Catsarepro21/hackpad_v2/README.md

# Macropad
A custom macropad with 6 keys, bluetooth(ESP32-S3), battery, RGB, 2 and rotary encoders. This is my second macropad, because the first one wasn't that good but I still have parts some parts left over from it. 

Files:

[PCB](PCB)

[Case](https://github.com/Catsarepro21/hackpad_v2/blob/main/case)

[Gerbers](PCB/gerbers.zip)

BOM: [BOM.md](BOM.md)

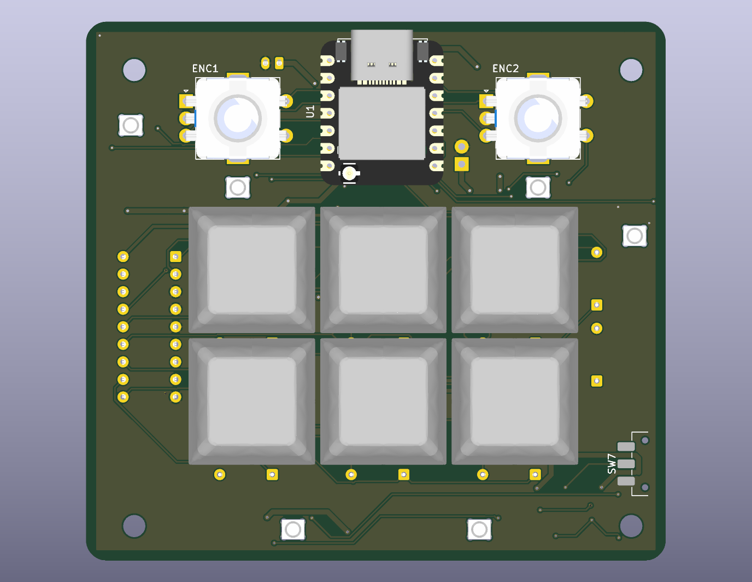
[picture p1: images/PCB-top.png]
PCB top


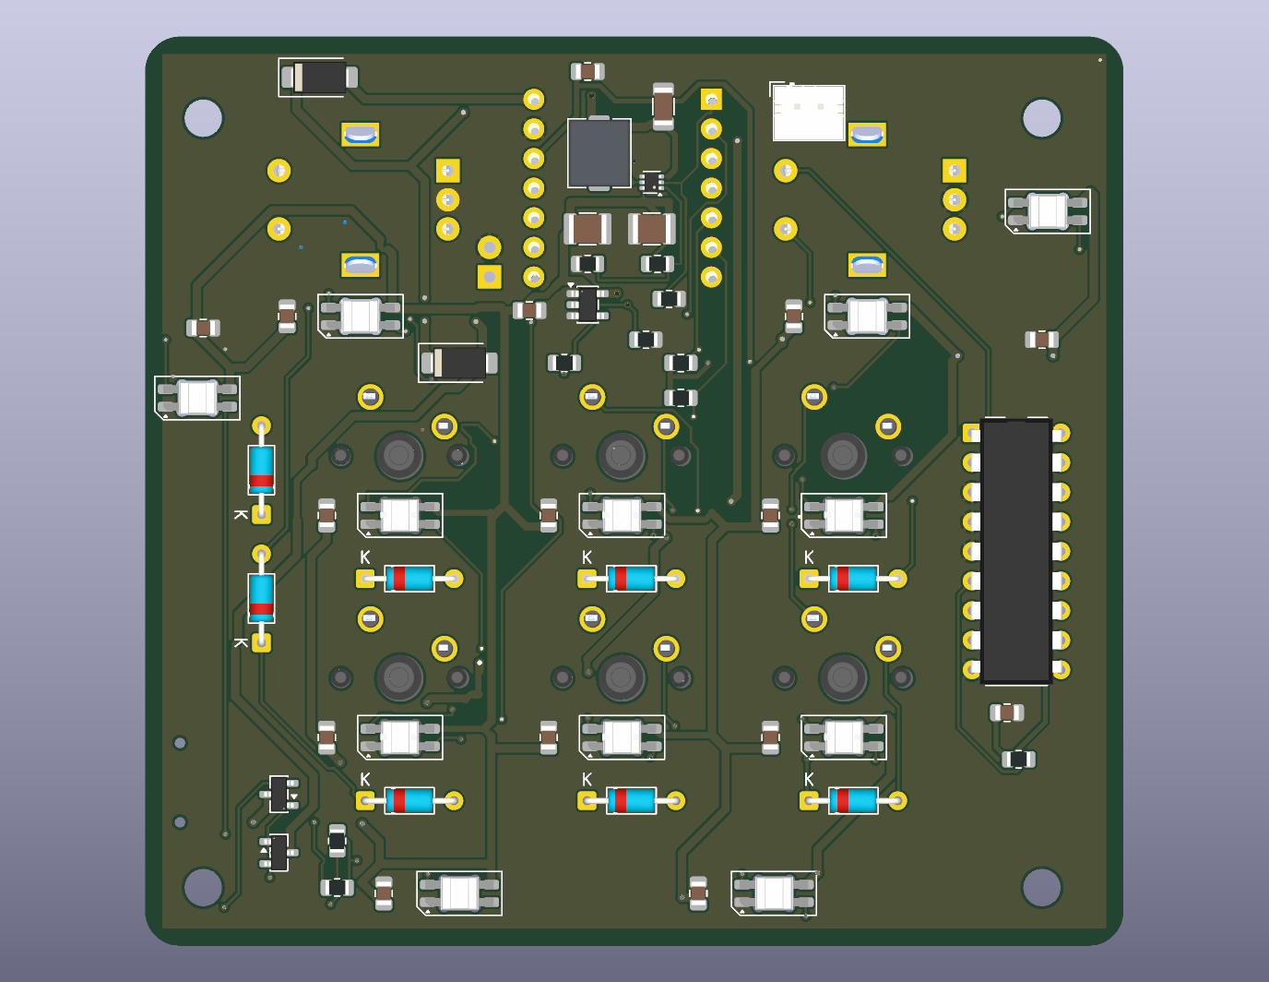
[picture p2: images/PCB-bottom.png]
PCB bottom


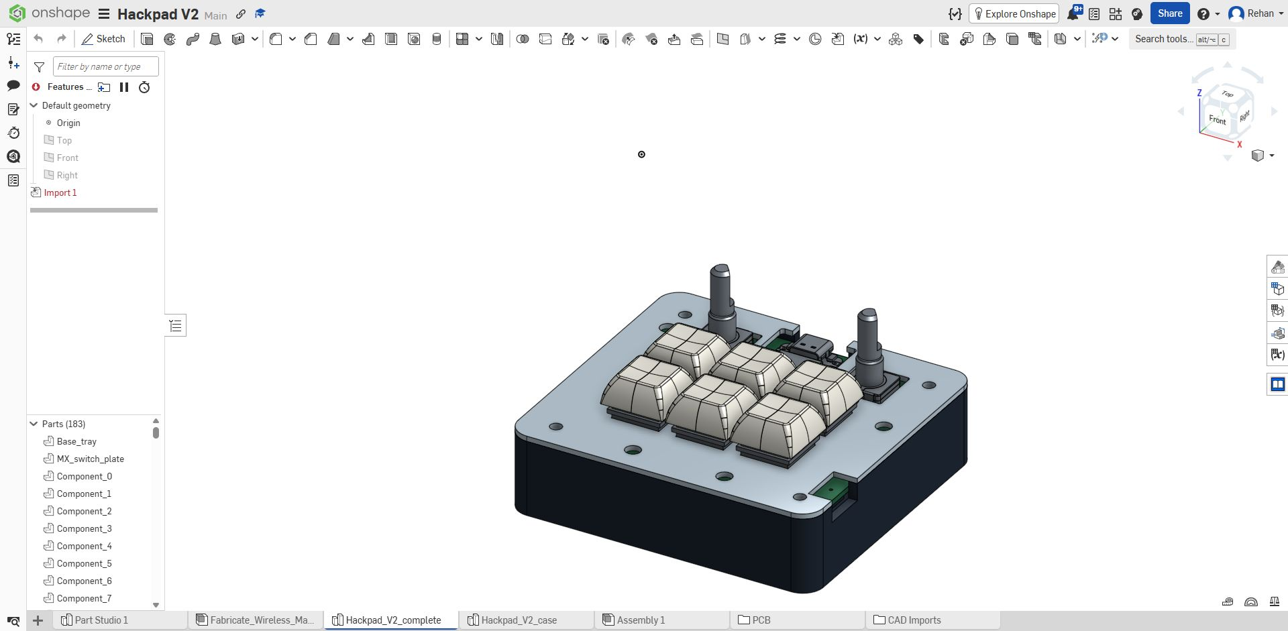
[picture p3: images/Onshape-enclosure.jpg]
Case


[Onshape](https://cad.onshape.com/documents/e5e00bd96b00b1f98fd3bff8/w/d80bdedc56342f5387c6fe9a/e/f05423852afba8350f5d5474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)
