Catsarepro21/hackpad_v2/BOM.md

| Reference/use | Part | Needed | Cart quantity | Line USD |
|---|---|---:|---:|---:|
| U1 | XIAO ESP32-S3 113991114, 1597-113991114-ND | 1 | 1 | 7.49 |
| J1 | B2B-PH-K-S, 455-1704-ND | 1 | 1 | 0.12 |
| U1 sockets | PPTC071LFBN-RC, S7005-ND | 2 | 2 | 1.16 |
| U1 male headers | Seeed 102010490 five-pack | 2 strips | 1 pack | 0.25 |
| U4 | SN74AHCT1G125DBVR, 296-4708-1-ND | 1 | 1 | 0.14 |
| R8,R9 | RC0805FR-07100KL, 311-100KCRCT-ND | 2 | 10 | 0.36 |
| R7 | RC0805FR-07330RL, 311-330CRCT-ND | 1 | 1 | 0.10 |
| R10 | RC0805FR-071KL, 311-1.00KCRCT-ND | 1 | 1 | 0.10 |
| Battery pad leads | Adafruit 1954 wire pack, 1528-1964-ND | 1 pair | 1 pack | 1.95 |
| Q1,Q2 | AO3401A, 785-1001-1-ND | 2 | 2 | 1.04 |
| C1,C6-C18 | CC0805KRX7R9BB104 100nF 50V X7R 0805, 311-1140-1-ND | 14 | 14 | 1.37 |
| C4 | CL32B226KOJNNNE 22uF 16V X7R 1210, 1276-1855-1-ND | 1 | 1 | 0.64 |
| SW7 | JS102011SAQN, 401-1999-1-ND | 1 | 1 | 0.90 |
| Battery | Adafruit 1578 protected 500mAh, 1528-1841-ND | 1 | 1 | 7.95 |
| PCB fabrication | JLCPCB | 1 board | 5 boards | 2.00 |
| Case printing | Printing Legion? Or friend | 1 case | 1 case | ? |
| Subtotal |  |  |  | 25.57 |
| Shipping |  |  |  | 16.44 |
| Total |  |  |  | 42.01 |
