Catsarepro21/hackpad_v2/case/Base_tray.step

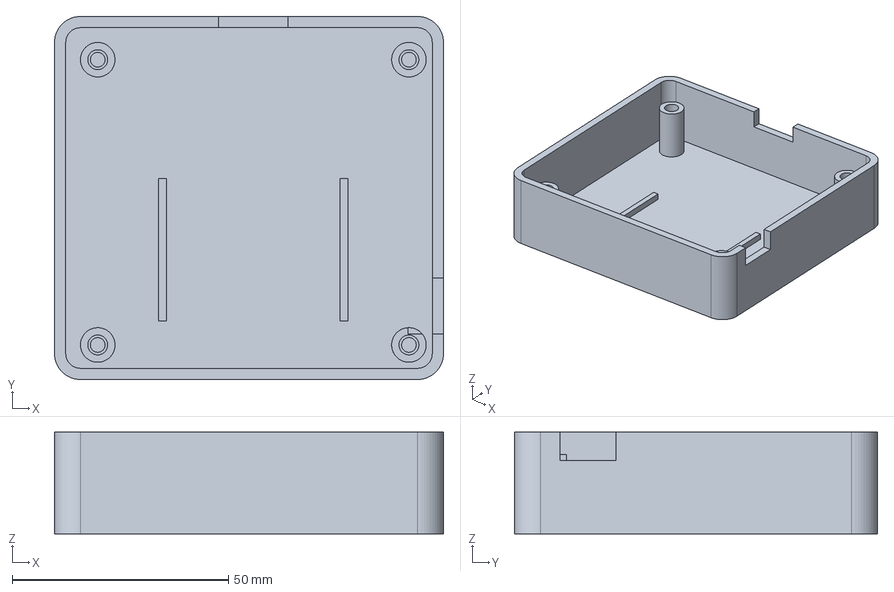
[picture p4: CAD file, 2026-10-19]
case/Base_tray.step
90.0 x 84.0 x 23.5 mm
