Catsarepro21/hackpad_v2/(list of files, cad)

Other CAD files:
case/Base_tray.stl
