Catsarepro21/hackpad_v2/JOURNAL.md

---
title: "Hackpad"
github: "https://github.com/Catsarepro21/hackpad_v2"
description: "A(nother) custom hackpad! I made one before for Keeb but it was really bad because I wasn't that good at PCB's, so i'm making a much better one, and I even have some parts left over."
created_at: "2026-10-15"
total_time: "6h 42m"
---

# October 15, 2026: Schematic, PCB, code, and case, so pretty much everything
<!-- fabricate:entry 503 -->

So I first wanted a much better layout, so I started by drawing in excalidraw.


. 
Then I started on the schematic, and I wanted bluetooth on this hackpad rather than not, and chose to add RGB under every key and around the edges. Then I made the schematic using an ESP32-S3(Kinda overkill but good for making it simpler), added all the RGB, rotary encoders, i removed the OLED cuz i lost it, and made sure to have a switch and battery connecter, and added 3d models for the parts from grabcad, just for reference to make sure it looked good and assigned all the footprints based on the known parts that I already have.



Then i made the PCB, and I just used normal 19.05 mx spacing and layed it out pretty quickly. I just dragged out the footprints in the grid for the keys and encoder, and I did the same for the ESP32, other parts i layed out where there was space to keep it square and I added RGB right under every key. And of course, i added M3 mounting holes so it would actually stay in my case.



After that i made the case in onshape, I imported the PCB and just added a margin, made a sketch based on the PCB and mounting holes, and extruded to make the bottom half. Then I used ai03 Plate Generator to generate the top half DXF and extended it and extruded the mounting holes through it, and added a hole for the switch.


Finally I made really basic code pretty quickly using Arduino IDE, and i did use Gemini's help a bit on this part but i did write it myself.

**Total time spent: 4h 30m**

# October 17, 2026: Cheapified
<!-- fabricate:entry 619 -->

I simplified the hackpad to bring the estimated parts order down to **$34.07 before tax**:

- Connected the keys and encoder clicks directly to the XIAO, so I don’t need to populate the MCP23008 or its supporting parts.
- Made RGB USB-only, letting me leave the battery RGB boost converter and its supporting parts unpopulated.
- Kept those extra footprints on the PCB so I can add the features later.
- Switched to a smaller protected 500mAh battery and used the XIAO’s built-in charger.
- Reused my existing switches, keycaps, encoders, LEDs, diodes, screws, and inserts.
- Consolidated the new parts into one DigiKey order.



**Total time spent: 1h 30m**

# October 20, 2026: Simplified Schematic and updated README and expanded Journal
<!-- fabricate:entry 772 -->

So today all i did was simplify the schematic by copying and pasting everything onto one page and removing the net labels and replacing with wires. Then I rewrote my readme and expanded my previous journals.



**Total time spent: 42m**
