Catsarepro21/hackpad_v2/PCB/Fabricate_Wireless_Macropad.kicad_pcb

## KiCad design PCB/Fabricate_Wireless_Macropad.kicad_pcb (2026-10-20)

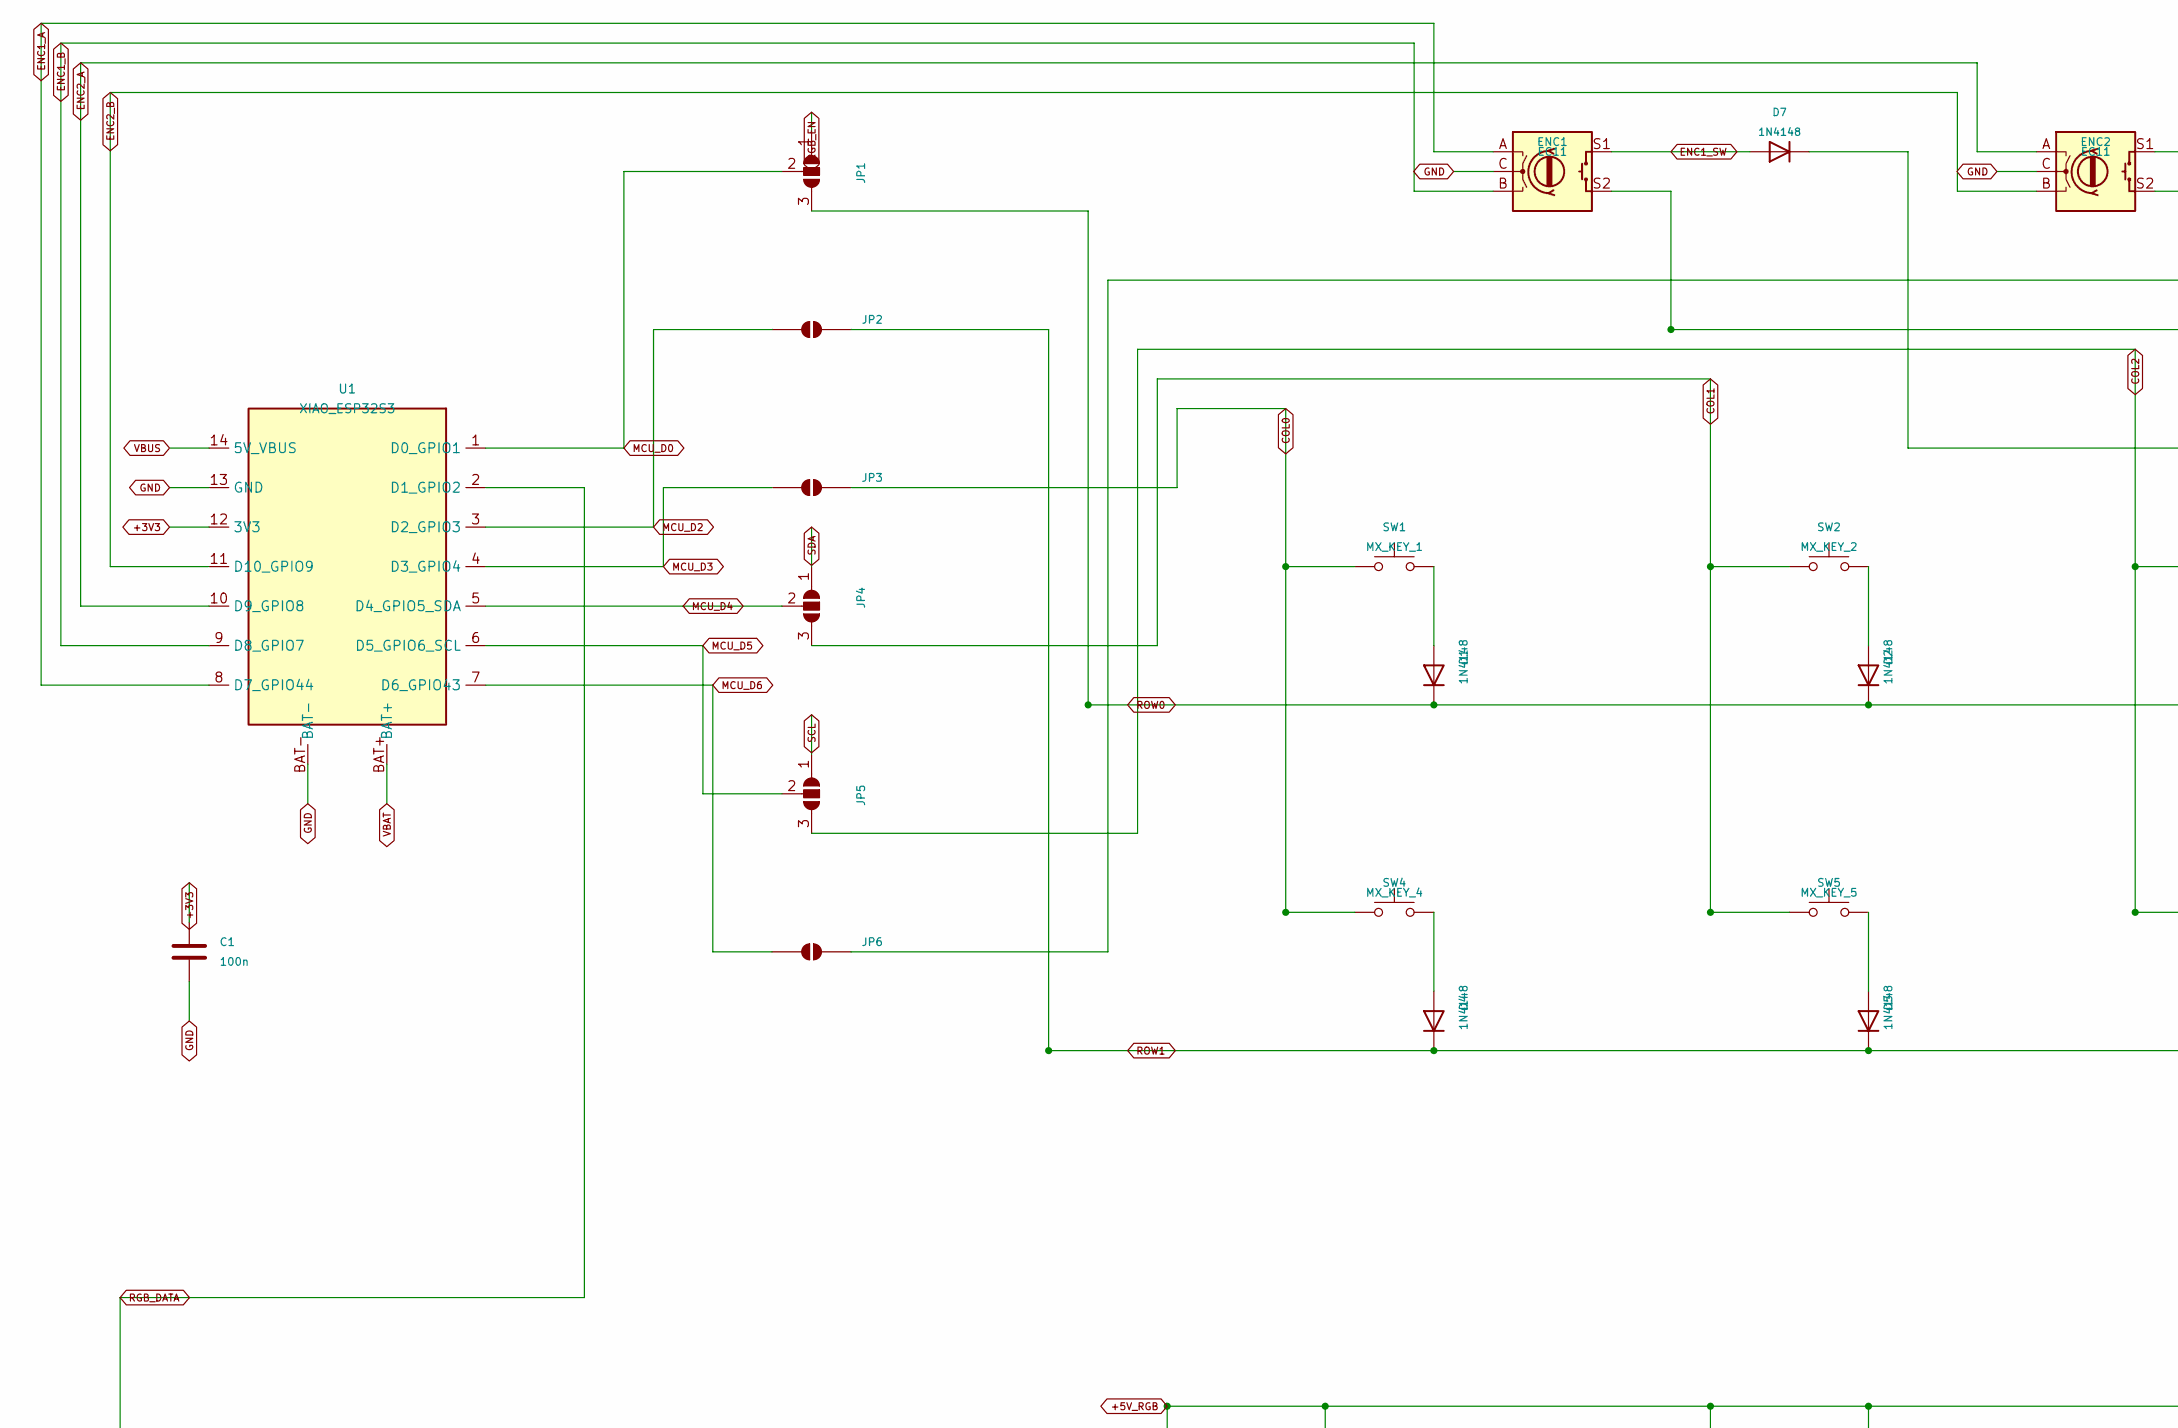
[picture p5: schematic Fabricate_Wireless_Macropad.kicad_sch, Hackpad V2 - complete circuit, part in row 1, column 1]

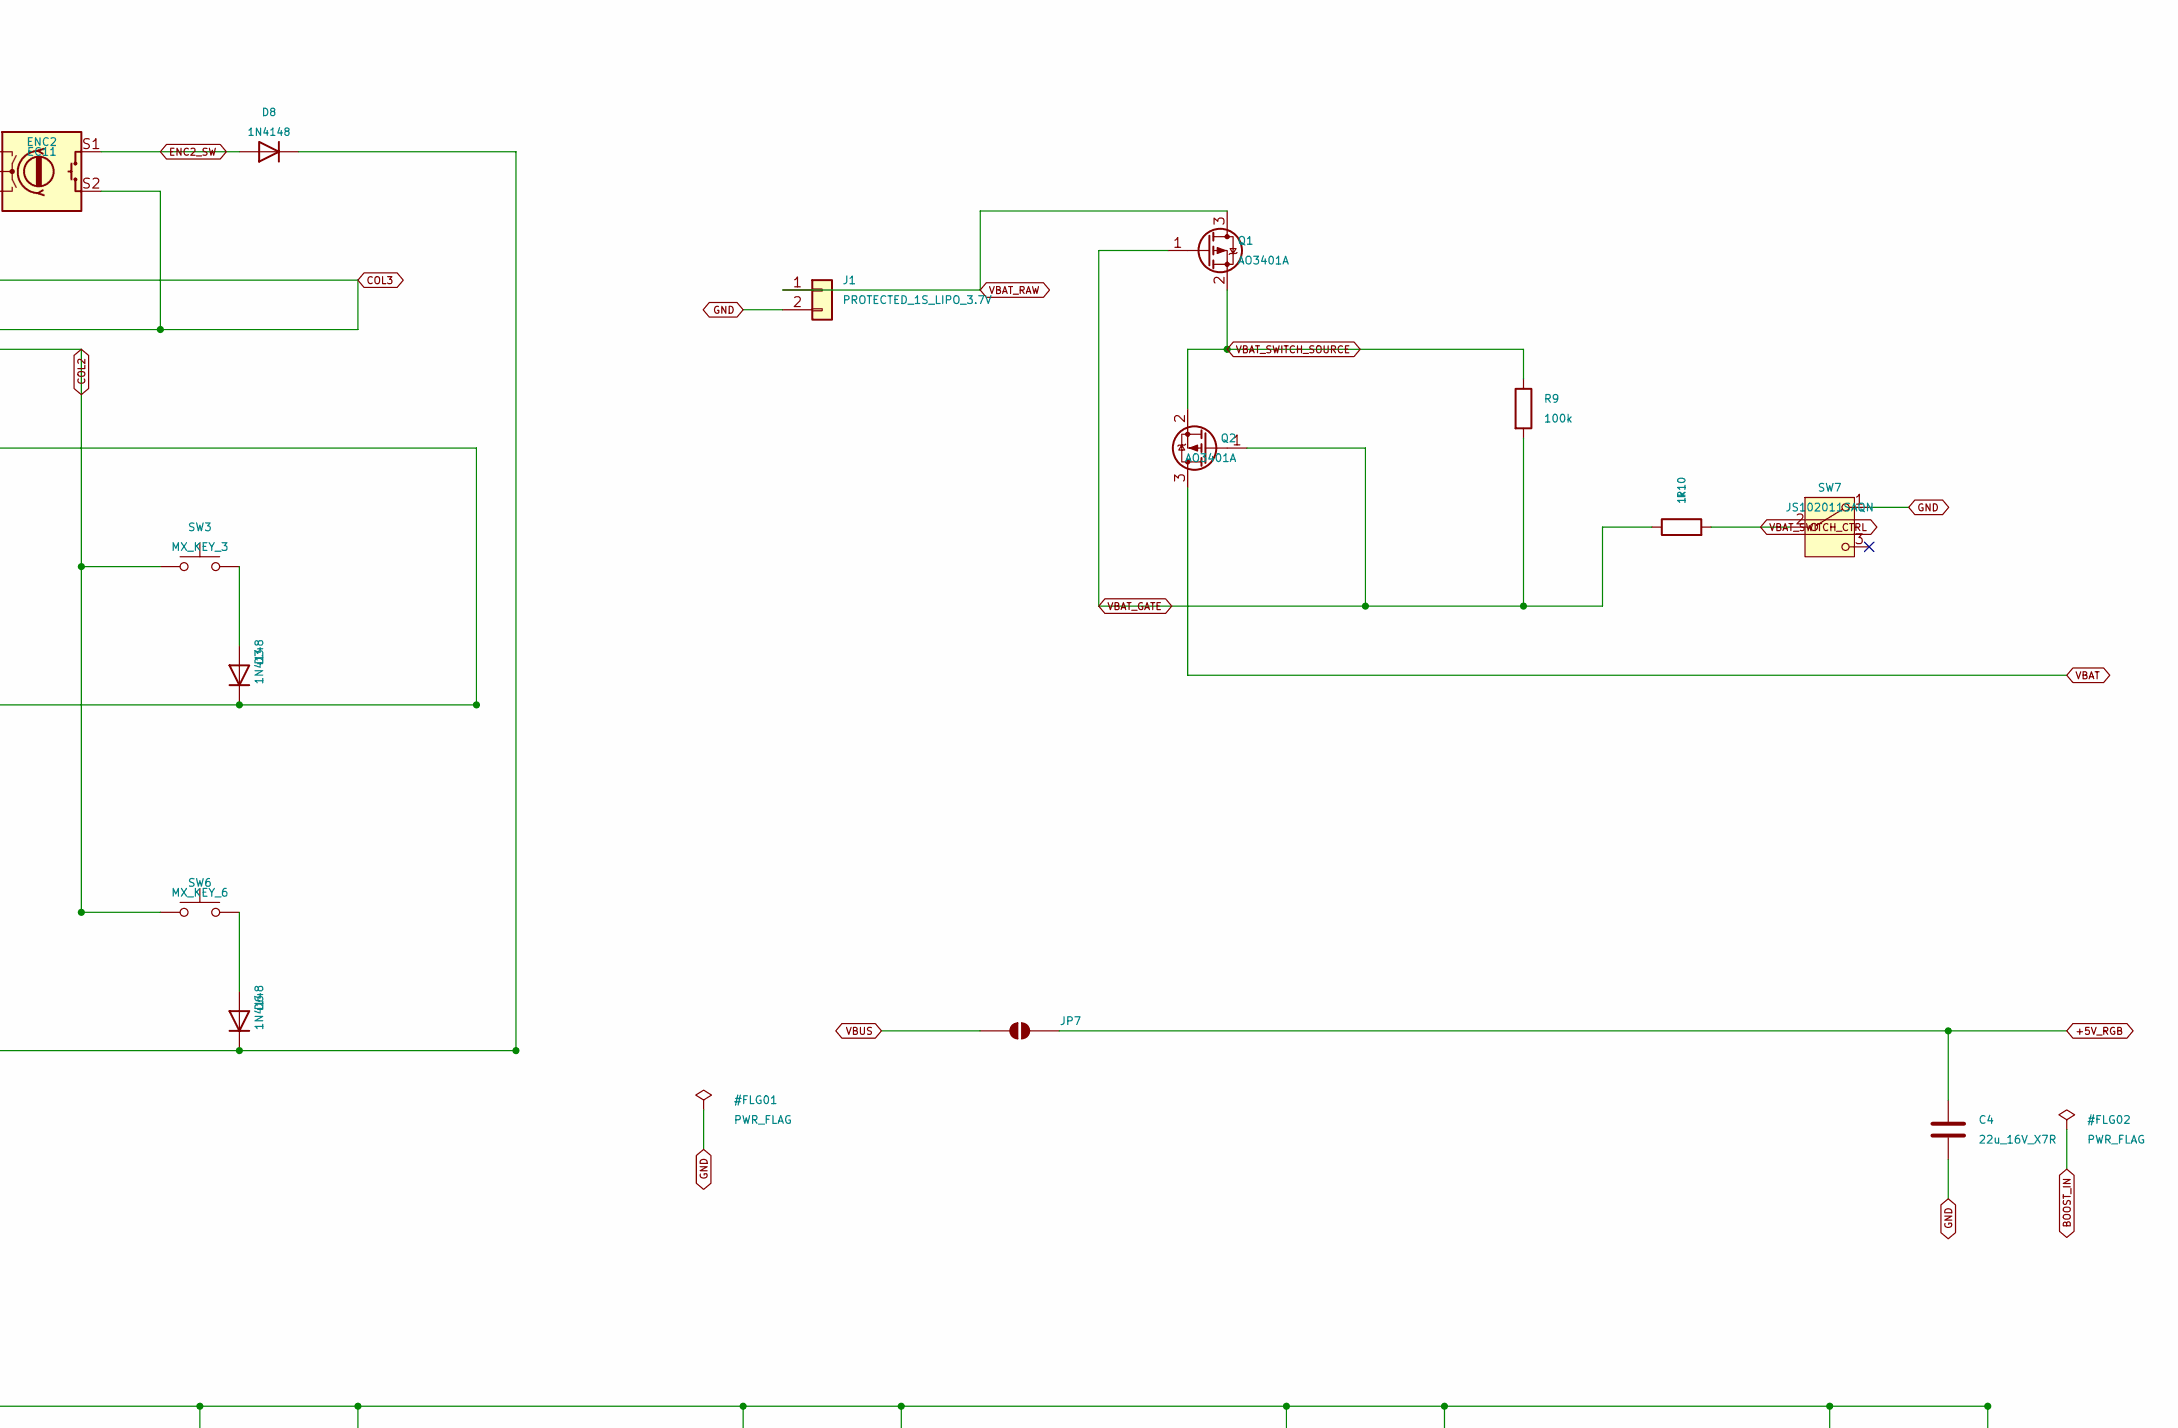
[picture p6: schematic Fabricate_Wireless_Macropad.kicad_sch, Hackpad V2 - complete circuit, part in row 1, column 2]

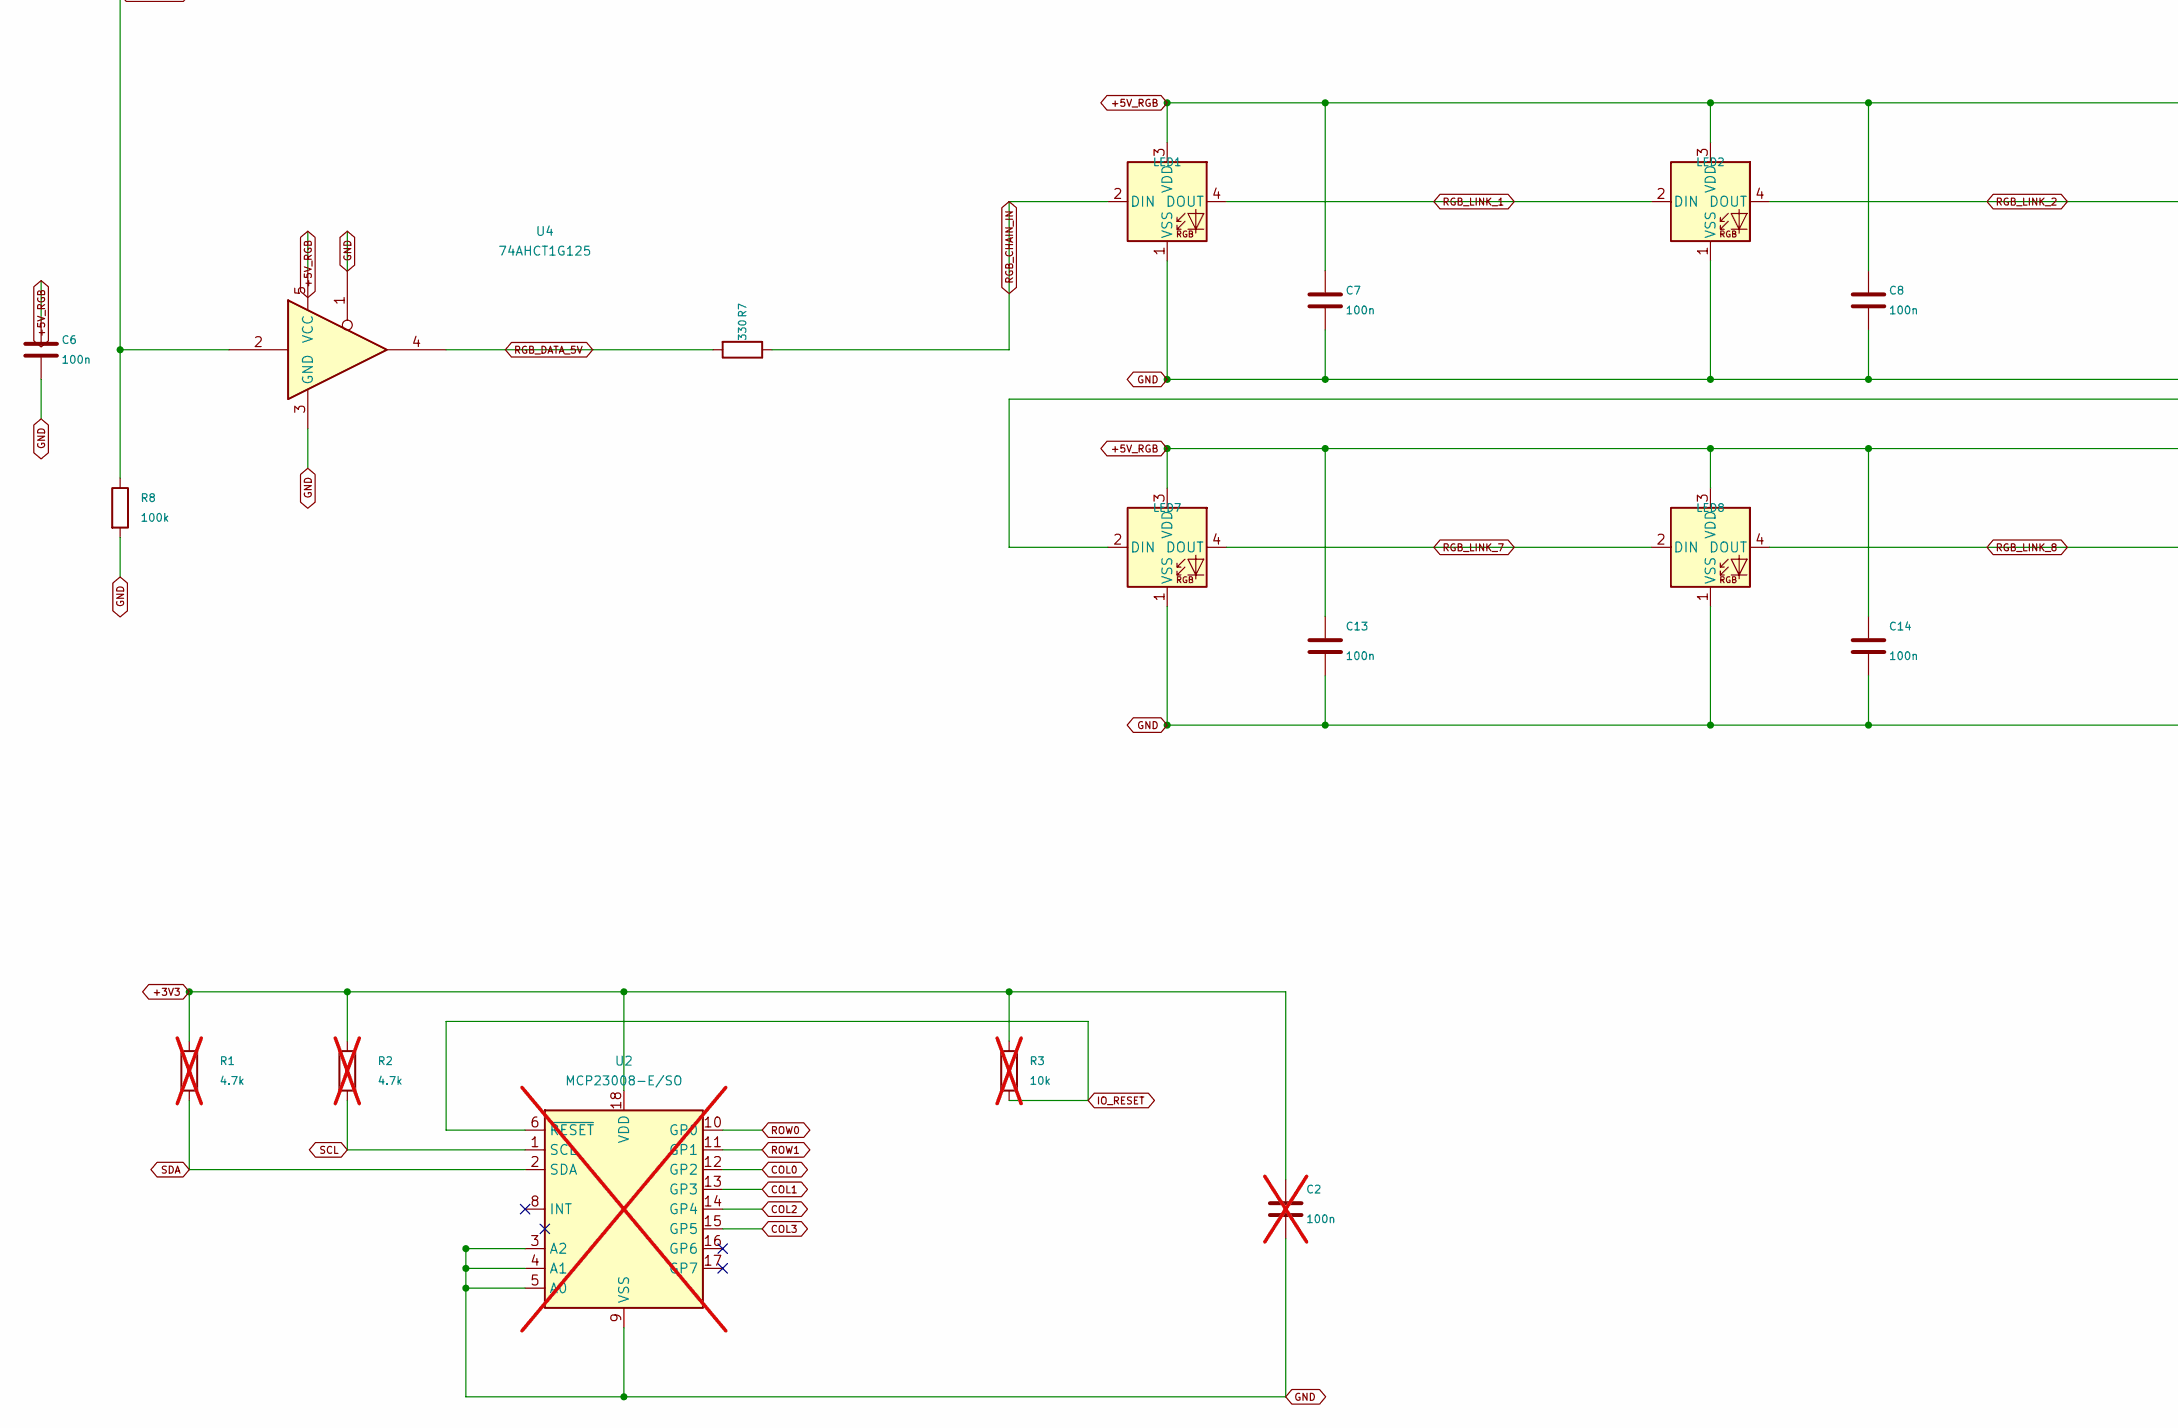
[picture p7: schematic Fabricate_Wireless_Macropad.kicad_sch, Hackpad V2 - complete circuit, part in row 2, column 1]

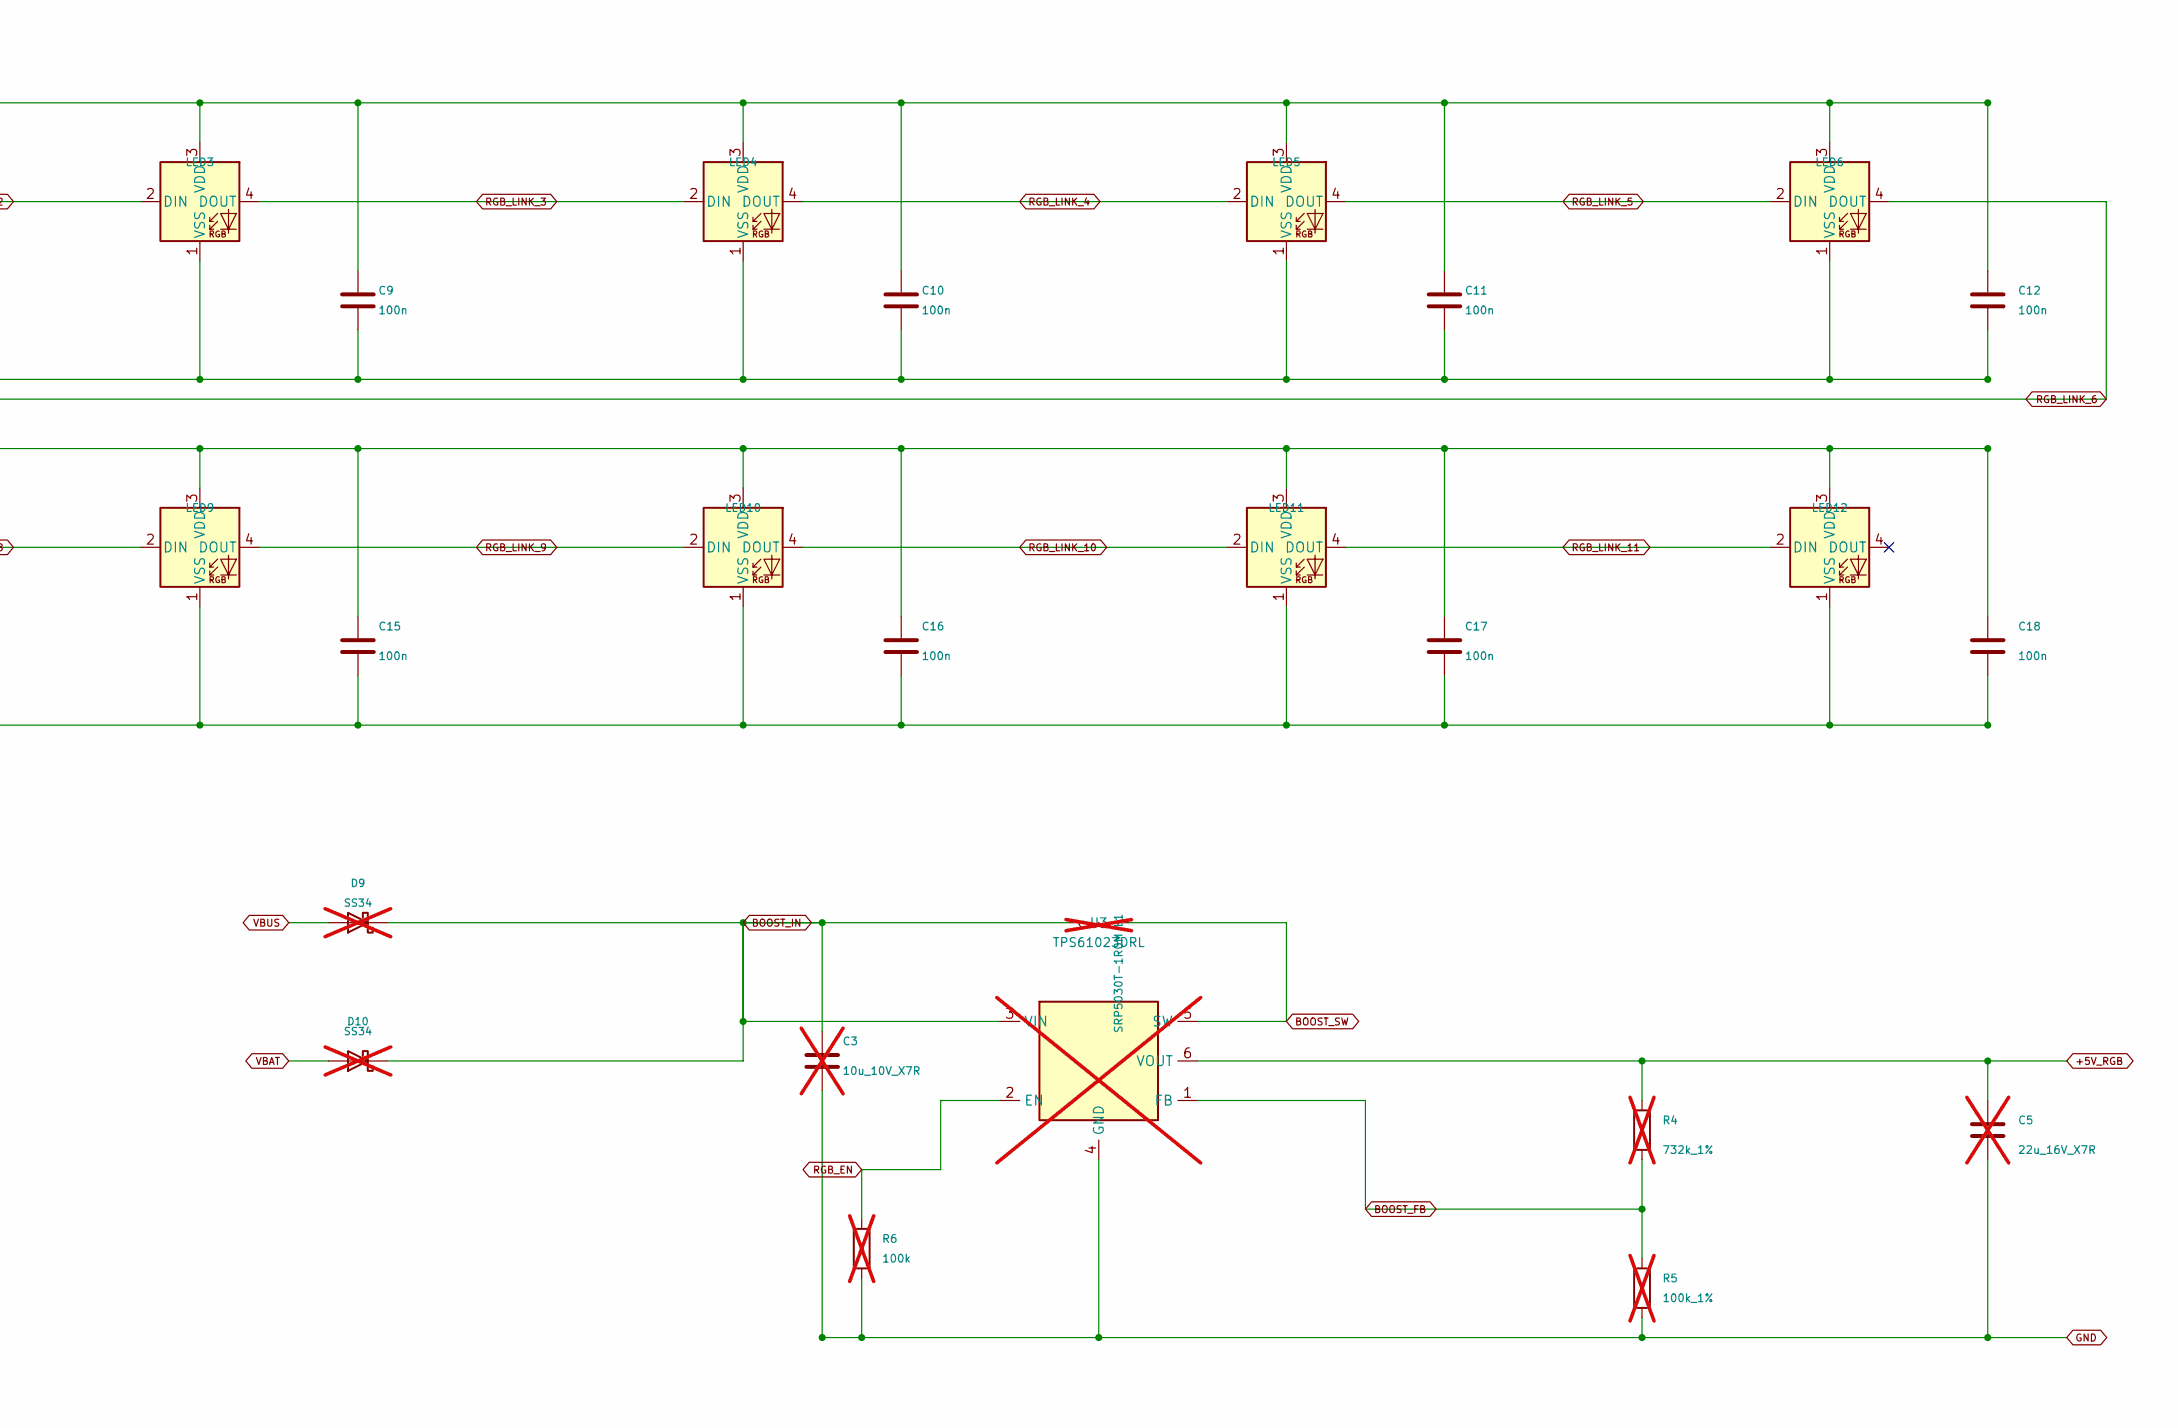
[picture p8: schematic Fabricate_Wireless_Macropad.kicad_sch, Hackpad V2 - complete circuit, part in row 2, column 2]

Parts:
C1, C6, C7, C8, C9, C10, C11, C12, C13, C14, C15, C16, C17, C18: 100n; C_0805_2012Metric
C2: 100n; C_0805_2012Metric; not fitted
C3: 10u_10V_X7R; C_1206_3216Metric; MPN C1206C106K8RACTU; LCSC C2167669; not fitted
C4: 22u_16V_X7R; C_1210_3225Metric; MPN CL32B226KOJNFNE; LCSC C16196563
C5: 22u_16V_X7R; C_1210_3225Metric; MPN CL32B226KOJNFNE; LCSC C16196563; not fitted
D1, D2, D3, D4, D5, D6, D7, D8: 1N4148; D_DO-35_SOD27_P7.62mm_Horizontal
D9, D10: SS34; D_SMA; not fitted
ENC1, ENC2: EC11; RotaryEncoder_Alps_EC11E-Switch_Vertical_H20mm
J1: PROTECTED_1S_LIPO_3.7V; JST_PH_B2B-PH-K_1x02_P2.00mm_Vertical
JP1, JP4, JP5: MODE_SELECT; SolderJumper-3_P1.3mm_Open_Pad1.0x1.5mm
JP2, JP3, JP6, JP7: MODE_SELECT; SolderJumper-2_P1.3mm_Open_Pad1.0x1.5mm
L1: SRP5030T-1R0M; L_Bourns_SRP5030T; MPN SRP5030T-1R0M; not fitted
LED1: KEY_1; LED_SK6812MINI-E_3.2x2.8mm_P1.5mm_ReverseMount; MPN SK6812MINI-E
LED2: KEY_2; LED_SK6812MINI-E_3.2x2.8mm_P1.5mm_ReverseMount; MPN SK6812MINI-E
LED3: KEY_3; LED_SK6812MINI-E_3.2x2.8mm_P1.5mm_ReverseMount; MPN SK6812MINI-E
LED4: KEY_4; LED_SK6812MINI-E_3.2x2.8mm_P1.5mm_ReverseMount; MPN SK6812MINI-E
LED5: KEY_5; LED_SK6812MINI-E_3.2x2.8mm_P1.5mm_ReverseMount; MPN SK6812MINI-E
LED6: KEY_6; LED_SK6812MINI-E_3.2x2.8mm_P1.5mm_ReverseMount; MPN SK6812MINI-E
LED7: ENC_1; LED_SK6812MINI-E_3.2x2.8mm_P1.5mm_ReverseMount; MPN SK6812MINI-E
LED8: ENC_2; LED_SK6812MINI-E_3.2x2.8mm_P1.5mm_ReverseMount; MPN SK6812MINI-E
LED9: EDGE_1; LED_SK6812MINI-E_3.2x2.8mm_P1.5mm_ReverseMount; MPN SK6812MINI-E
LED10: EDGE_2; LED_SK6812MINI-E_3.2x2.8mm_P1.5mm_ReverseMount; MPN SK6812MINI-E
LED11: EDGE_3; LED_SK6812MINI-E_3.2x2.8mm_P1.5mm_ReverseMount; MPN SK6812MINI-E
LED12: EDGE_4; LED_SK6812MINI-E_3.2x2.8mm_P1.5mm_ReverseMount; MPN SK6812MINI-E
Q1, Q2: AO3401A; SOT-23
R1, R2: 4.7k; R_0805_2012Metric; not fitted
R3: 10k; R_0805_2012Metric; not fitted
R4: 732k_1%; R_0805_2012Metric; not fitted
R5: 100k_1%; R_0805_2012Metric; not fitted
R6: 100k; R_0805_2012Metric; not fitted
R7: 330; R_0805_2012Metric
R8, R9: 100k; R_0805_2012Metric
R10: 1k; R_0805_2012Metric
SW1: MX_KEY_1; SW_Cherry_MX_1.00u_PCB
SW2: MX_KEY_2; SW_Cherry_MX_1.00u_PCB
SW3: MX_KEY_3; SW_Cherry_MX_1.00u_PCB
SW4: MX_KEY_4; SW_Cherry_MX_1.00u_PCB
SW5: MX_KEY_5; SW_Cherry_MX_1.00u_PCB
SW6: MX_KEY_6; SW_Cherry_MX_1.00u_PCB
SW7: JS102011SAQN; SW_SPDT_CK_JS102011SAQN
U1: XIAO_ESP32S3; XIAO_S3_Socket_WiredBattery
U2: MCP23008-E/SO; SOIC-18W_7.5x11.6mm_P1.27mm; MPN MCP23008-E/SO; not fitted
U3: TPS61023DRL; SOT-563; not fitted
U4: 74AHCT1G125; SOT-23-5

Connections:
+3V3: C1.1, C2.1, R1.1, R2.1, R3.1, U1.12 (3V3), U2.18 (VDD)
+5V_RGB: C4.1, C5.1, C6.1, C7.1, C8.1, C9.1, C10.1, C11.1, C12.1, C13.1, C14.1, C15.1, C16.1, C17.1, C18.1, JP7.2 (B), LED1.3 (VDD), LED2.3 (VDD), LED3.3 (VDD), LED4.3 (VDD), LED5.3 (VDD), LED6.3 (VDD), LED7.3 (VDD), LED8.3 (VDD), LED9.3 (VDD), LED10.3 (VDD), LED11.3 (VDD), LED12.3 (VDD), R4.1, U3.6 (VOUT), U4.5 (VCC)
BOOST_FB: R4.2, R5.1, U3.1 (FB)
BOOST_IN: C3.1, D9.1 (K), D10.1 (K), L1.2, U3.3 (VIN)
BOOST_SW: L1.1, U3.5 (SW)
COL0: JP3.2 (B), SW1.1, SW4.1, U2.12 (GP2)
COL1: JP4.3 (B), SW2.1, SW5.1, U2.13 (GP3)
COL2: JP5.3 (B), SW3.1, SW6.1, U2.14 (GP4)
COL3: ENC1.S2, ENC2.S2, JP6.2 (B), U2.15 (GP5)
ENC1_A: ENC1.A, U1.8 (D7_GPIO44)
ENC1_B: ENC1.B, U1.9 (D8_GPIO7)
ENC1_SW: D7.2 (A), ENC1.S1
ENC2_A: ENC2.A, U1.10 (D9_GPIO8)
ENC2_B: ENC2.B, U1.11 (D10_GPIO9)
ENC2_SW: D8.2 (A), ENC2.S1
GND: C1.2, C2.2, C3.2, C4.2, C5.2, C6.2, C7.2, C8.2, C9.2, C10.2, C11.2, C12.2, C13.2, C14.2, C15.2, C16.2, C17.2, C18.2, ENC1.C, ENC2.C, J1.2, LED1.1 (VSS), LED2.1 (VSS), LED3.1 (VSS), LED4.1 (VSS), LED5.1 (VSS), LED6.1 (VSS), LED7.1 (VSS), LED8.1 (VSS), LED9.1 (VSS), LED10.1 (VSS), LED11.1 (VSS), LED12.1 (VSS), R5.2, R6.2, R8.2, SW7.1 (A), U1.13 (GND), U1.BAT-, U2.3 (A2), U2.4 (A1), U2.5 (A0), U2.9 (VSS), U3.4 (GND), U4.1, U4.3 (GND)
IO_RESET: R3.2, U2.6 (~RESET)
MCU_D0: JP1.2 (C), U1.1 (D0_GPIO1)
MCU_D2: JP2.1 (A), U1.3 (D2_GPIO3)
MCU_D3: JP3.1 (A), U1.4 (D3_GPIO4)
MCU_D4: JP4.2 (C), U1.5 (D4_GPIO5_SDA)
MCU_D5: JP5.2 (C), U1.6 (D5_GPIO6_SCL)
MCU_D6: JP6.1 (A), U1.7 (D6_GPIO43)
unnamed: D1.2 (A), SW1.2
unnamed: D2.2 (A), SW2.2
unnamed: D3.2 (A), SW3.2
unnamed: D4.2 (A), SW4.2
unnamed: D5.2 (A), SW5.2
unnamed: D6.2 (A), SW6.2
RGB_CHAIN_IN: LED1.2 (DIN), R7.1
RGB_DATA: R8.1, U1.2 (D1_GPIO2), U4.2
RGB_DATA_5V: R7.2, U4.4
RGB_EN: JP1.1 (A), R6.1, U3.2 (EN)
RGB_LINK_1: LED1.4 (DOUT), LED2.2 (DIN)
RGB_LINK_2: LED2.4 (DOUT), LED3.2 (DIN)
RGB_LINK_3: LED3.4 (DOUT), LED4.2 (DIN)
RGB_LINK_4: LED4.4 (DOUT), LED5.2 (DIN)
RGB_LINK_5: LED5.4 (DOUT), LED6.2 (DIN)
RGB_LINK_6: LED6.4 (DOUT), LED7.2 (DIN)
RGB_LINK_7: LED7.4 (DOUT), LED8.2 (DIN)
RGB_LINK_8: LED8.4 (DOUT), LED9.2 (DIN)
RGB_LINK_9: LED9.4 (DOUT), LED10.2 (DIN)
RGB_LINK_10: LED10.4 (DOUT), LED11.2 (DIN)
RGB_LINK_11: LED11.4 (DOUT), LED12.2 (DIN)
ROW0: D1.1 (K), D2.1 (K), D3.1 (K), D7.1 (K), JP1.3 (B), U2.10 (GP0)
ROW1: D4.1 (K), D5.1 (K), D6.1 (K), D8.1 (K), JP2.2 (B), U2.11 (GP1)
SCL: JP5.1 (A), R2.2, U2.1 (SCL)
SDA: JP4.1 (A), R1.2, U2.2 (SDA)
VBAT: D10.2 (A), Q2.3 (D), U1.BAT+
VBAT_GATE: Q1.1 (G), Q2.1 (G), R9.2, R10.1
VBAT_RAW: J1.1, Q1.3 (D)
VBAT_SWITCH_CTRL: R10.2, SW7.2 (B)
VBAT_SWITCH_SOURCE: Q1.2 (S), Q2.2 (S), R9.1
VBUS: D9.2 (A), JP7.1 (A), U1.14 (5V_VBUS)

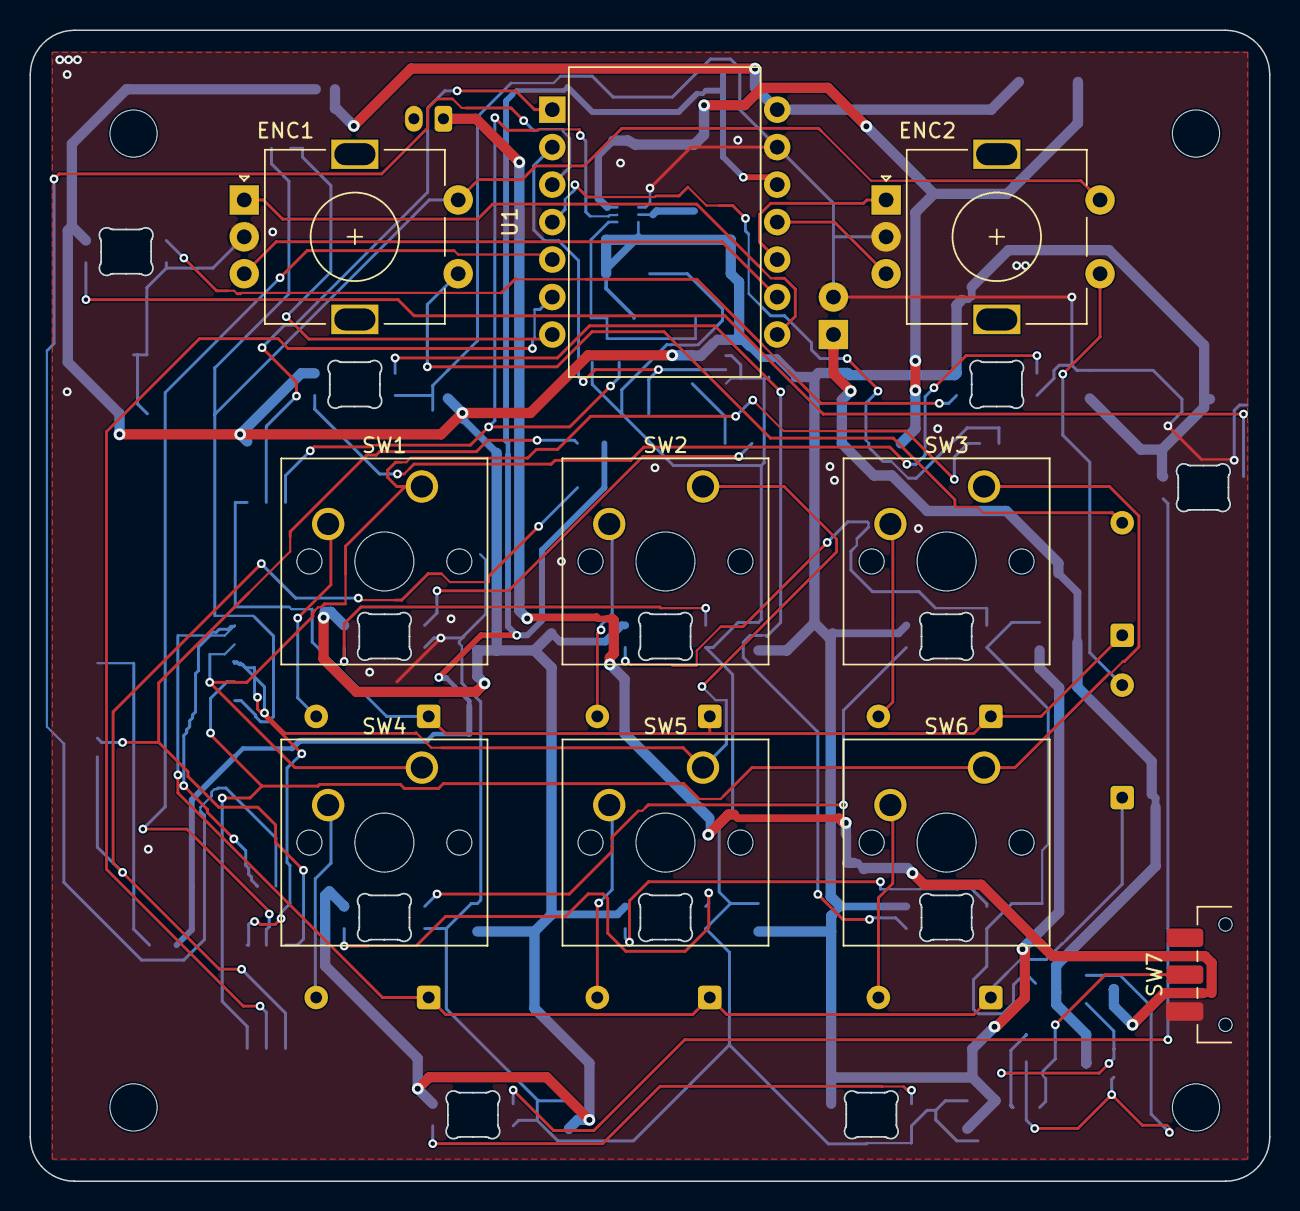
[picture p9: board Fabricate_Wireless_Macropad.kicad_pcb from above]

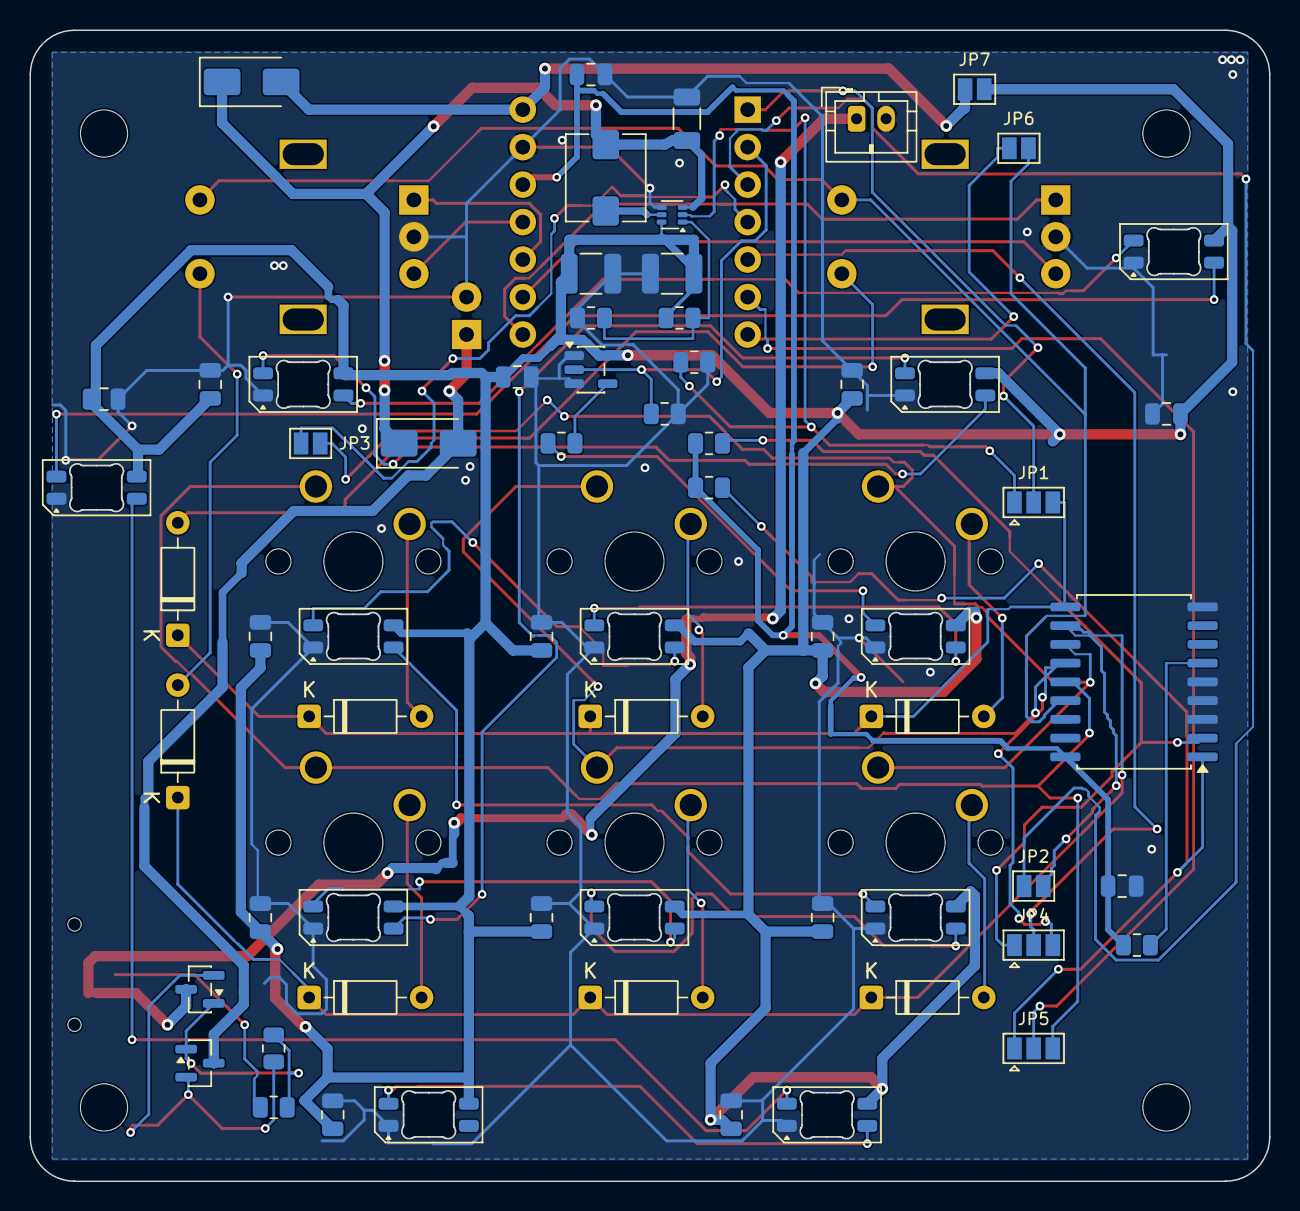
[picture p10: board Fabricate_Wireless_Macropad.kicad_pcb from below]

Board: 2 copper layers, 84.0 x 78.0 mm, 78 parts (64 on the bottom side), 54 nets.

Other parts of the board:
MH1, MH2, MH3, MH4: MountingHole_3.2mm_M3
