Catsarepro21/hackpad_v2/(commit log)

2026-10-16 added all files
    [BOM.csv, Base_tray.step, Cherry MX.STEP, DSA_Keycap_CherryMX.step, EC11-THT-20F-blue.step, Fabricate_Wireless_Macropad.kicad_pcb, Fabricate_Wireless_Macropad.kicad_sch, Fabricate_Wireless_Macropad.step]
2026-10-16 Clean up BOM by removing unnecessary sections
    Removed outdated budget details and choices critique from BOM.
2026-10-16 Update BOM.csv with new parts and quantities
    Replaced the BOM.csv file with an updated version that includes new entries and modifications to existing items.
    [BOM.csv]
2026-10-16 Simplify BOM and remove price basis column
    [BOM.csv]
2026-10-16 Update BOM.md to remove estimated total cost
    Removed estimated total cost from BOM.
2026-10-16 Update BOM.md by removing outdated notes
    Removed notes about the XIAO charger and LED count.
2026-10-16 Revise purchase conditions in BOM.csv
    Updated BOM.csv to modify purchase conditions for battery leads and case.
    [BOM.csv]
2026-10-16 Add Arduino code for USB HID controller with encoders
2026-10-16 updated BOM
    [BOM.csv]
2026-10-16 updated parts
    [BOM.csv, Base_tray.step, Hackpad_V2_case.step]
2026-10-17 Updated wih cheeaper pads
    [BOM.csv, Base_tray.step, Base_tray.stl, Build_Options.kicad_sch, Fabricate_Wireless_Macropad.kicad_pcb, Fabricate_Wireless_Macropad.kicad_sch, Fabricate_Wireless_Macropad.step, Hackpad_V2_case.step]
2026-10-20 updated PCB and gerbers
    [BOM.csv, Fabricate_Wireless_Macropad.kicad_pcb, Fabricate_Wireless_Macropad.kicad_sch]
2026-10-21 Update BOM with PCB and case printing
    [BOM.csv]
